revaldinho/z80tube/README.md

# z80tube
Card to allow an Amstrad CPC computer to connect to an Acorn Tube or other 6502 bus devices
