revaldinho/z80tube/(commit log)

2018-11-25 Initial checkin of all files as at first bringup
    [CPC_6502_V1.00.brd]
2018-11-28 Updated host code with MAXAM assembler
2018-12-01 Add ID in Tube release after LOAD
2018-12-02 rename tube code to TUBE.ASC
2018-12-02 uncomment unhandled readch print statement, change hex to 32 bytes per line
2018-12-16 reset all tube ctrl bits at start; wait on sync bits
2019-07-04 Add 5th slave pin (unused currently) to match with cpc-cplink
2019-07-10 Add v1.01 release with working XC95108 JEDEC and restored verilog/ucf
    [CPC_6502_V1.00.brd]
